jjderlatka/IntegratedDesignProject/measurements.xlsx

From Cross (centre) to end of ramp |  |  |  | 30 full rotations |  | 6m flat
start | end | total
4.574074074e-05 | 0.0002001157407 | 0.000154375 |  |  |  | 0:01:00
9.178240741e-05 | 0.0002444212963 | 0.0001526388889 |  |  |  | 0:01:00
6.076388889e-05 | 0.0002155439815 | 0.0001547800926 |  |  |  | 0:01:01
6.232638889e-05 | 0.0002168634259 | 0.000154537037 |  |  |  | 0:01:00
0.0001358217593 | 0.0002905439815 | 0.0001547222222 |  |  |  | 0:01:01
5.210648148e-05 | 0.0002076157407 | 0.0001555092593
6.657407407e-05 | 0.0002224537037 | 0.0001558796296
3.304398148e-05 | 0.0001892939815 | 0.00015625
3.304398148e-05 | 0.000188912037 | 0.0001558680556
3.292824074e-05 | 0.0001892939815 | 0.0001563657407
5.148148148e-05 | 0.0002072337963 | 0.0001557523148
 |  | 0.0001551525673 | avg |  |  | 0:01:00 | avg
 |  | 3.726851852e-06 | max - min |  |  | 1.076388889e-05 | max - min
 |  |  |  |  | 60.362 |  | speed
