jjderlatka/IntegratedDesignProject/(commit log)

2022-01-25 Add files via upload
    Powerpoint 25/01/22
2022-01-29 robot class, motors interaction
2022-02-02 line following bugfixes, switch brakes
    [DCMotorTest.ino, sketch.ino]
2022-02-03 removed prints
2022-02-07 calibration spreadsheet
    [measurements.xlsx]
2022-02-13 broken movement into individual pieces
    [sketch.ino]
2022-02-16 servo pin changed to 9
